Artod/lstk-eye/(commit log)

2026-07-30 feat: project scaffold - config, wire protocol, pipeline interfaces, Claude planner
    - pydantic wire protocol for the device (scenes of text/arrow/chevron primitives,
    HTTP request/response only, device-initiated)
    - pluggable pipeline interfaces (STT, segmenter, planner, relocalizer, calibration)
    with lazy factories and a mock profile that runs without models or API keys
    - config via TOML + LSTK_* env vars + CLI overrides
    - Anthropic planner: Set-of-Marks image + question -> structured step plan
2026-07-30 feat: pipeline stages - STT, segmentation, Set-of-Marks, planners, relocalization
    - whisper STT (faster-whisper) + mock; WAV utils on stdlib wave; EN/RU voice
    intent matching (next/prev/repeat/cancel)
    - FastSAM segmenter + deterministic classical-CV mock; numbered-badge marks
    overlay and debug slide renderer
    - mock planner and experimental claude-cli planner backend (reuses a local
    Claude Code install instead of an API key)
    - template-matching relocalizer: multi-scale TM_CCOEFF_NORMED, appear-fast/
    disappear-lazy hysteresis, EMA-smoothed anchor, resolution-independent
2026-07-30 feat: camera-display calibration and scene composer
    - window model: display center shows a configured camera point, panel spans a
    configured fraction of the frame; least-squares fit helper for the physical
    calibration procedure
    - composer renders slides (wrapped label, step counter, arrow snapped to 45
    degrees, edge chevrons for out-of-window targets) and status/error screens
2026-07-30 feat: session state machine, HTTP server, CLI
    - per-device session: photo buffer, ask pipeline (STT -> segment -> marks ->
    plan -> slides), slide navigation, voice intents, preview-driven anchor
    updates with change-only scene bumps
    - FastAPI transport (raw-body endpoints, threadpool offload), mDNS
    advertisement as lstk-eye.local, per-request run persistence
    - CLI: serve / simulate / demo / doctor; example TOML config
2026-07-30 feat: device simulator - drive the server without hardware
    - SimulatedGlasses HTTP client mirroring the firmware (capture/ask/event/
    preview), mock-STT text injection, ASGI-transport support for tests
    - faithful offline renderer of display scenes to PNG (text, arrows, chevrons)
    - scripted scenario runner used by the simulate CLI command
2026-07-30 test: offline suite for every module plus end-to-end session flow
    190 tests: audio/STT/intents, segmentation and marks, all planner backends,
    calibration and composer geometry, relocalizer hysteresis, simulator client
    and renderer, protocol round-trips, and server e2e over ASGI (mock profile).
    Real-model smoke tests (whisper tiny, FastSAM) are opt-in via -m slow.
2026-07-30 feat: XIAO ESP32S3 firmware - camera, HUD, gestures, mic, HTTP client
    - device state machine: capture on click, record on long press, ask on
    release, slide advance on double click, preview streaming while a session
    is active
    - OV5640 with autofocus init, XGA capture / QVGA preview switching
    - SSD1306 scene renderer (mirrored init for the single-reflection optical
    path), ArduinoJson scene parsing
    - PDM mic to WAV in PSRAM, capped at 20 s
    - WiFi + mDNS resolution of lstk-eye.local with IP fallback
    compiles clean: 34% flash, 18% RAM (esp32 core 3.3.11, PSRAM=opi)
2026-07-30 fix: defects found in adversarial review
    Server:
    - active flag desync: a mid-session ask with no fresh photo no longer tells
    the device the session ended while the server keeps it alive
    - mid-session captures acknowledge in the count only instead of replacing the
    slide scene (scenes are full-replace and nothing restored the slide)
    - relocalization tracker starts visible: hiding costs the full miss budget
    even on the first (often motion-blurred) preview frames
    - non-blocking preview/scene polling: frames are dropped instead of convoying
    behind a long ask and starving the threadpool
    - request body size caps (413) on photos/ask/preview; session eviction bounds
    the per-device_id map; e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
    [buttons.cpp, buttons.h, cam.cpp, device_config.example.h]
2026-08-02 fix: non-blocking WiFi reconnect keeps the button FSM alive while offline
    The reconnect path blocked loop() for up to 22 s per attempt (blocking
    net_connect + delay), so with WiFi down the button never got polled - found
    on first hardware bring-up. loop() now uses net_ensure(): re-kicks WiFi.begin
    at most every 10 s, never blocks, resolves the server host lazily on the
    first moment of connectivity, and draws the HUD status only on transitions.
    Also silences the 'sta is connecting, cannot set config' log spam by
    disconnecting before re-begin.
    [lstk_eye_glasses.ino, net.cpp, net.h]
2026-08-02 feat: full-white OLED sketch for optics alignment
    Lights every pixel at max contrast so the panel's active-area boundary is
    visible through the lens/beamsplitter while positioning the optics.
2026-08-02 feat: object-highlight mode and visible-area padding
    - new 'target' display element: four corner brackets framing the object,
    sized from its bbox - find-this questions (single anchored step) render as
    a highlight instead of an instruction arrow; single-step sessions hide the
    step counter
    - off-window targets get a compass chevron inset at the visible border
    - DisplayConfig pads: the optics crop the panel edges, so all layout (text,
    counters, arrows, chevrons, brackets) stays inside a configurable visible
    rectangle; chevrons gained optional explicit coordinates on the wire
    - planner prompts (real and mock) return exactly one step for find/locate
    questions; firmware and simulator r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
2026-08-02 feat: chat model, double-click reset, and voice-triggered calibration
    - the session is now an ongoing chat: (question, answer) history is kept per
    device, passed to the planner, and follow-up photo+question turns work
    back and forth; double click sends the new 'reset' event that clears
    session, history, and photo buffer
    - mid-chat captures acknowledge with a photo-count badge on the current
    scene instead of going silent
    - calibration flow: saying 'calibrate' shows crosshairs on the HUD; the
    wearer aligns a generated ArUco target (lstk-eye target) with each of
    three points and clicks; the server detects the marker, solves the window
    model, applies it live, and persists it to the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
    [device_config.example.h]
2026-08-02 fix: calibration UX overhaul, live marker feedback, photo integrity guards
    - calibration previews now drive a live feedback line on the HUD (marker OK /
    no marker seen / closer to marker / near edge) so the wearer knows whether
    a click will land before clicking; clicks that cannot land do not count
    - every calibration click is saved under runs/calibration/ with a detection
    overlay for debugging misses
    - marker acceptance checks (min apparent size, edge margin) and a fit sanity
    gate that restarts the flow with a clear message instead of silently
    storing a bad mapping
    - error scenes always name the exit (2click = reset)
    - root-caused the QVGA-as-photo bug: after a framesize switch th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
    [cam.cpp]
2026-08-02 fix: calibration detection robustness, camera rotation, interaction-matrix gaps
    - fiducial detection accepts all common ArUco/AprilTag families at any id
    (users display whatever generator output they find) with a 2x upscale
    fallback for small markers; recovers 8 of 9 real failed calibration clicks
    - camera.rotation config normalizes every ingested frame upright (sideways
    module mount); applied at a single decode chokepoint
    - calibration crosshair enlarged to fit-the-marker brackets (r=16) matching
    a phone-displayed marker at working distance; size window 0.045..0.35 with
    a 'further from marker' state
    - questions during calibration stay in the flow ('busy: 2click exits')
    instead o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
2026-08-02 fix: calibration exit paths, transient-prompt restore, input hygiene
    Fixes from an adversarial interaction audit (19 confirmed findings):
    - voice/HTTP cancel of calibration fully deactivates the session (was:
    active=True with an empty deck -> IndexError on repeat/back, active-flag
    desync between /scene and the device)
    - 'stop calibration' phrasings cancel instead of restarting (cancel wins
    over the calibrate keyword while calibrating)
    - empty or punctuation-only transcripts never reach the pipeline and keep
    the crosshair during calibration
    - transient prompts (no photo / didn't catch that) hold the screen ~4 s,
    suppress tracker redraws, then previews restore the slide automatically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
    [hud.cpp]
2026-08-02 fix: calibration geometry and completion flow, UX spec
    - crosshair points inset by the bracket radius: point 3 rendered its
    brackets above the panel (y=10, r=16 -> clipped at -6) and point 2 past
    the right border; brackets now always render whole
    - camera.rotation corrected 270 -> 90: click data showed both axes inverted
    (display +x -> camera -x), i.e. the previous guess was 180 degrees off,
    which made every fit produce negative windows and fail the sanity gate as
    'redo 1/3' with no explanation
    - mirrored solutions (negative windows) are now accepted as valid affine
    models - a 180-degree rotation mistake degrades to a working calibration
    plus a log warning instead of an endless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
2026-08-02 feat: floating labels, worker-task firmware, honest not-in-view behavior
    - find-mode HUD rework: the label floats with the target brackets (above,
    else below, always whole); off-window targets get the label beside the
    compass chevron; a lost target shows only the object name + 'look back' -
    no marker is ever drawn from a low-confidence match
    - compass edge chosen by overshoot against the VISIBLE area, not the panel:
    targets in the cropped left margin pointed 'right'
    - planner prompt: if the asked object is not clearly present, say so -
    never anchor to the closest look-alike; looking away / too close are
    normal cases
    - relocalization thresholds raised (0.70/0.55, EMA 0.5) after th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
    [device_config.example.h, lstk_eye_glasses.ino]
2026-08-02 fix: camera mirror normalization, tracker temporal consistency, session logs
    - CameraConfig gains flip_v/flip_h applied after rotation: a negative fitted
    calibration window on exactly one axis diagnoses a sensor mirror; frames
    reaching segmentation and the planner are now genuinely upright instead of
    vertically flipped
    - relocalization: re-appearing after a loss needs two consecutive confident
    matches agreeing on position, and a confident match teleporting away from
    the smoothed center counts as a miss - look-alike blobs (clothing) no
    longer produce phantom markers or wrong-direction compasses; a fully
    turned-away wearer gets 'look back', nothing else
    - whisper backend wraps co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
    [lstk_eye_glasses.ino]
2026-08-02 feat: capture reuse for refinements, structure-verified tracking, live bracket scale
    - a follow-up question without a new click reruns the pipeline on the
    active task's capture ('no, the RED tulip'); a fresh click still takes
    priority as the new context
    - tracker adds a Laplacian-correlation structure gate: a candidate match
    must share edge structure with the template, so flat same-brightness
    blobs (clothing) can no longer impersonate a textured target and flap
    the HUD between arrows and 'look back'
    - preview frames are replicate-padded before matching, so a target half
    out of the camera frame keeps matching (and the edge compass keeps
    pointing) instead of dropping to 'look bac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
    [lstk_eye_glasses.ino]
2026-08-02 fix: heap corruption on repeated recordings - per-recording WAV buffer
    The worker frees the WAV after uploading, but mic_record_stop handed out the
    mic module's persistent reused buffer: the first ask freed live memory, the
    second recording wrote through the dangling pointer over reallocated camera
    buffers, and the allocator asserted CORRUPT HEAP on a later free (serial
    backtrace captured on hardware). The buffer is now allocated per recording
    and ownership genuinely transfers to the worker; an empty recording frees it
    in place. mic_begin keeps a one-shot PSRAM probe so a missing PSRAM still
    fails loudly at boot.
    [mic.cpp]
2026-08-02 feat: coarse-to-fine refinement, marker tween, honest cant-see, faster tracking
    - find answers anchored to masks over 15% of the frame trigger a zoomed
    second pass: the region is cropped, re-segmented at native resolution, and
    the planner points again inside the zoom - small parts (a resistor on a
    board, a port on a meter) resolve to their own mask instead of the whole
    object; falls back to the coarse answer on any failure
    - lost target now shows a single small honest 'cant see' line - no label
    block, no implied direction; floating and compass labels are forced to
    one short word
    - structure-verified matches re-appear on the first frame (temporal double
    confirmation stays only f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
    [hud.cpp]
2026-08-02 feat: direct-pointing localization with model-driven zoom, demo-grade tracking
    Architecture change for find-questions: instead of Set-of-Marks over a
    segment-everything pass, the model localizes the target itself - it returns
    normalized center + tight box, and when the detail is too small to point at
    precisely it requests a zoom region; the server crops, re-asks (max 2
    rounds), and maps coordinates back. Any object scale resolves - a resistor
    on a board, a port on a meter - and segmentation leaves the critical path.
    Non-find questions keep the Set-of-Marks pipeline.
    - session routes find-questions to planner.locate() with fallback to SoM;
    trackers now build from the model's box (no mask n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
    [device_config.example.h, hud.cpp]
2026-08-02 perf: GPU speech recognition, precision-first locate, snappier defaults
    - new stt backend 'mlx' (mlx-whisper on Apple-silicon GPU): large-v3-turbo
    transcribes 2-4 s of speech in ~0.3-0.5 s at large-v3 accuracy - the
    dominant chunk of the 'thinking...' wait was CPU whisper; weights warm up
    at server start so the first ask does not pay the load
    - locate: zoom is now mandatory for small targets (<10% of image width) with
    tight-box rules (soldering-grade precision framing), the wide first view
    is downscaled to 800 px to cut prefill latency, every round logs
    status/coords/region, and output tokens are capped
    - planner effort default 'low' - perception calls do not need deliberation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
2026-08-03 feat: corner alignment grid on boot screens
    Bold L-brackets at the physical panel corners (padding ignored on purpose)
    drawn on the splash and WiFi status screens. They mark the true OLED extents
    so an external camera can be framed against them for demo filming - rebooting
    the device is the no-reflash way to bring the grid up; any interaction
    replaces it with normal scenes.
    [hud.cpp, hud.h, lstk_eye_glasses.ino]
2026-08-03 fix: lint errors that slipped past local checks
    - stt/whisper: missing PipelineError import (broke the readable-error path)
    - session: surface calibration save failures on the HUD instead of dropping
    the note (silent loss on reboot otherwise)
    - tests: import placement, unused loop variable
